PascalPflueger/Schwarmroboter-Beachlorarbeit-/Bilder/Screenshot_3.png

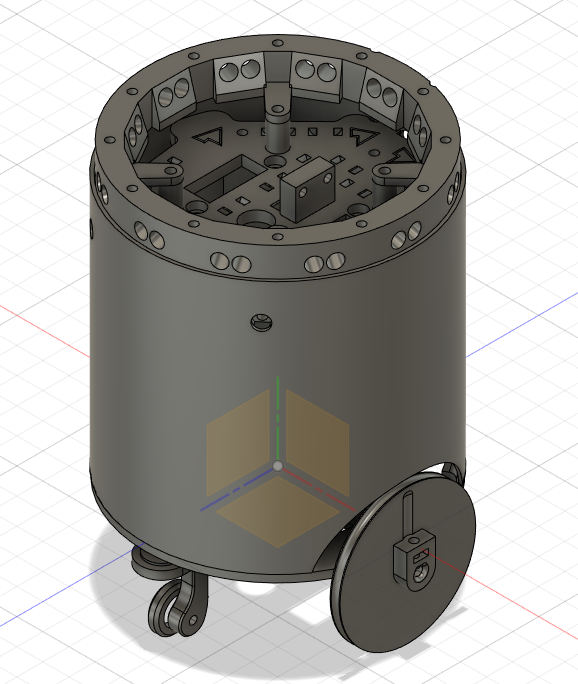
Bilder/Screenshot_3.png
