PascalPflueger/Schwarmroboter-Beachlorarbeit-/Bilder/IMG_5607.JPG

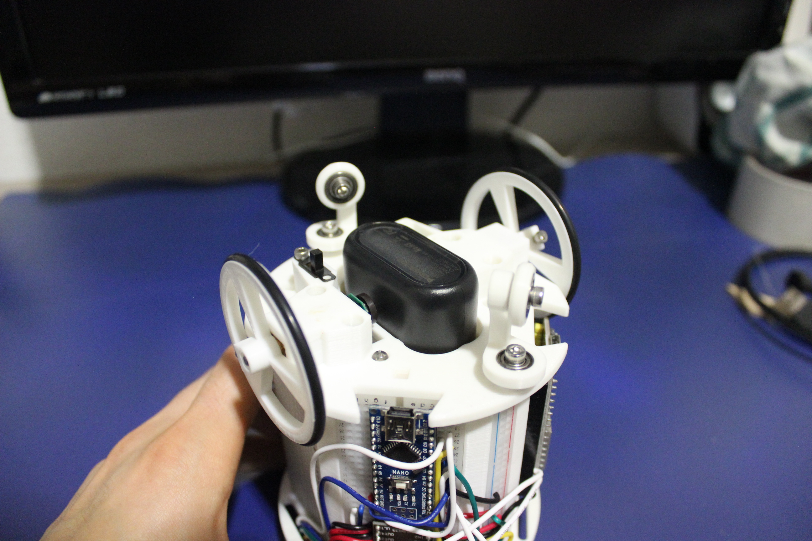
Bilder/IMG_5607.JPG
