PascalPflueger/Schwarmroboter-Beachlorarbeit-/3D-gedruckte Bauteile/Hauptkörper 1.png

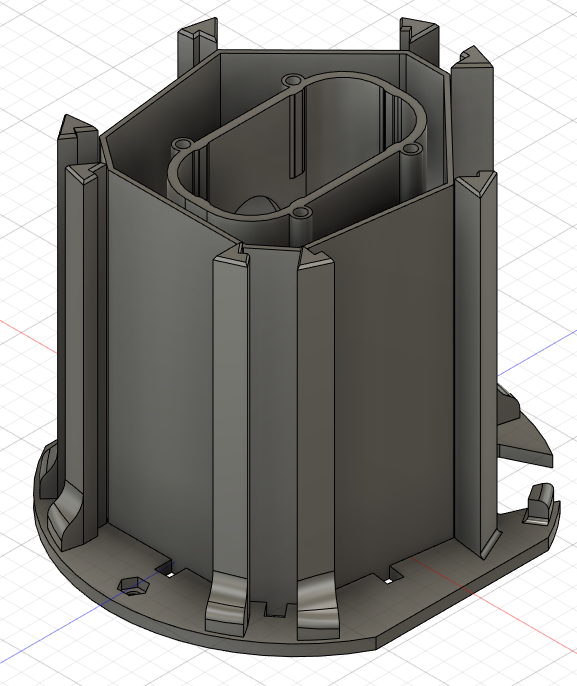
3D-gedruckte Bauteile/Hauptkörper 1.png
