PascalPflueger/Schwarmroboter-Beachlorarbeit-/3D-gedruckte Bauteile/Hauptkörper 2.png

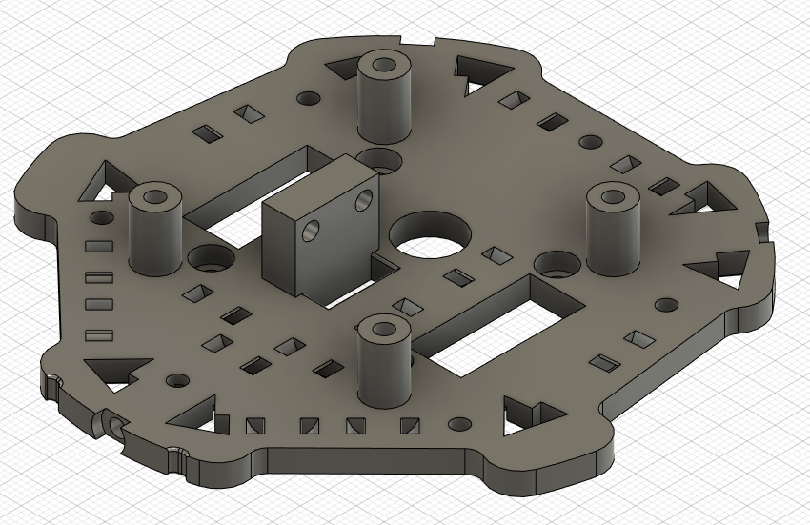
3D-gedruckte Bauteile/Hauptkörper 2.png
