PascalPflueger/Schwarmroboter-Beachlorarbeit-/3D-gedruckte Bauteile/Hülle.png

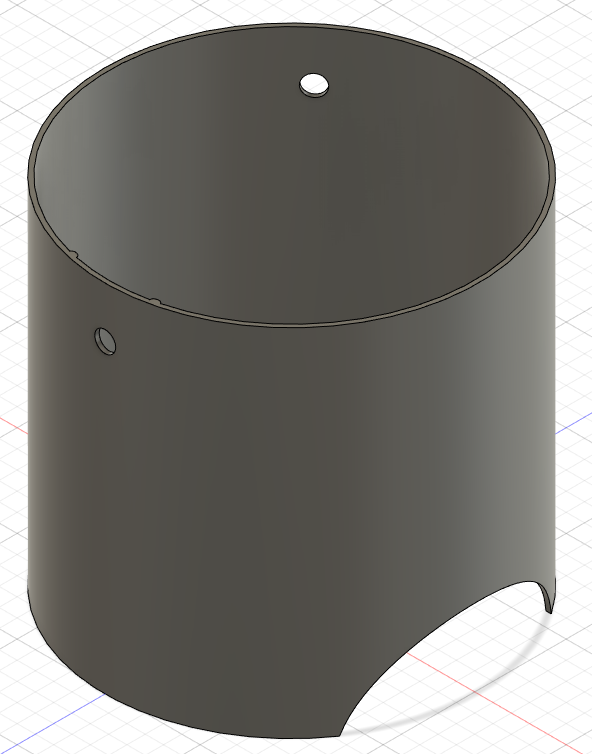
3D-gedruckte Bauteile/Hülle.png
