PascalPflueger/Schwarmroboter-Beachlorarbeit-/3D-gedruckte Bauteile/IR-Sensor-Halterung.png

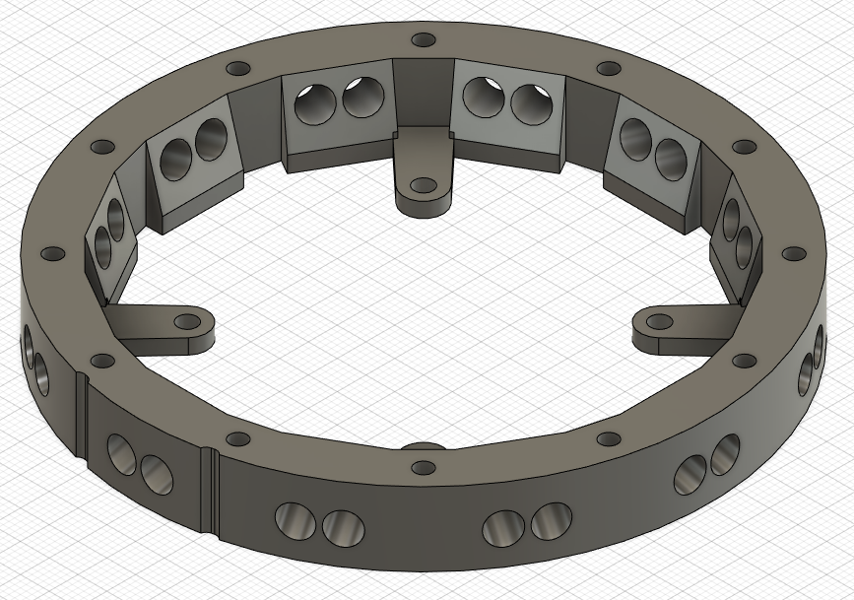
3D-gedruckte Bauteile/IR-Sensor-Halterung.png
