PascalPflueger/Schwarmroboter-Beachlorarbeit-/3D-gedruckte Bauteile/Motorhalterung Links.png

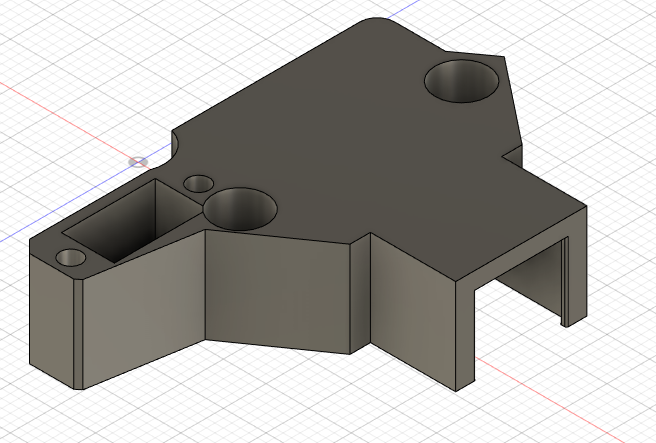
3D-gedruckte Bauteile/Motorhalterung Links.png
