PascalPflueger/Schwarmroboter-Beachlorarbeit-/3D-gedruckte Bauteile/Motorhalterung Rechts.png

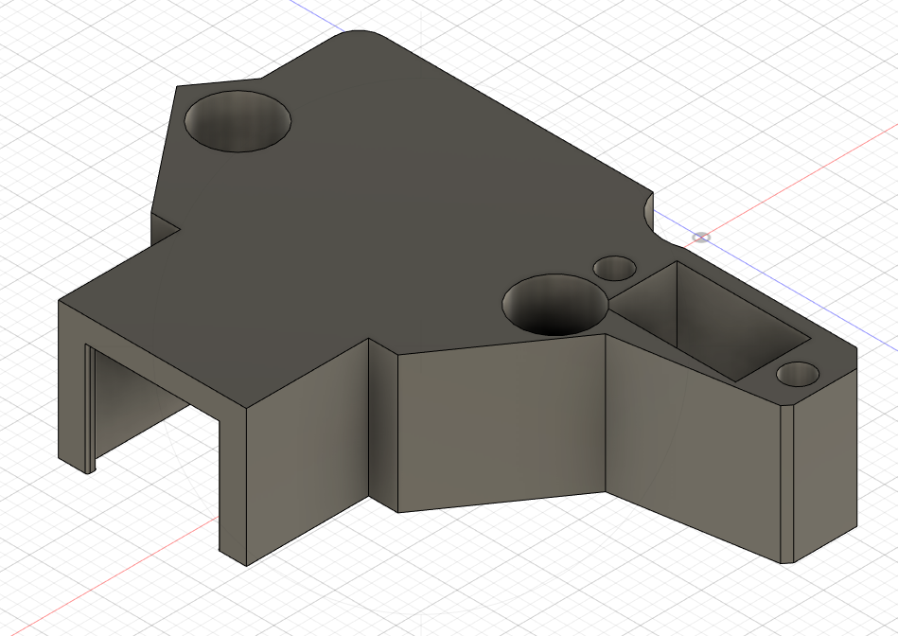
3D-gedruckte Bauteile/Motorhalterung Rechts.png
