PascalPflueger/Schwarmroboter-Beachlorarbeit-/3D-gedruckte Bauteile/Rad.png

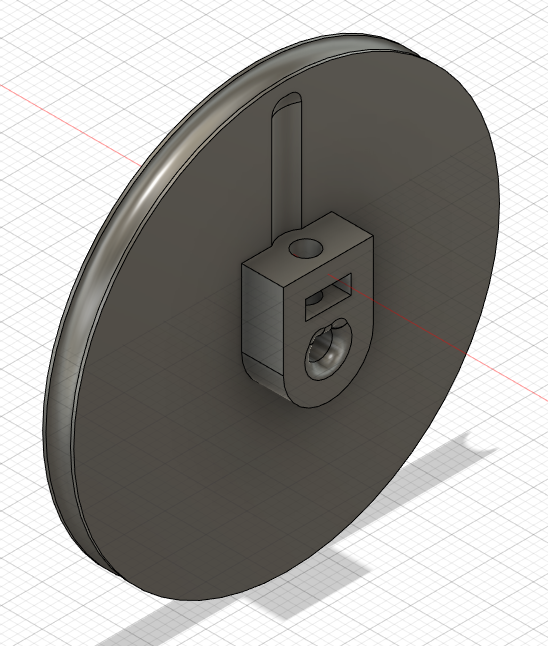
3D-gedruckte Bauteile/Rad.png
