PascalPflueger/Schwarmroboter-Beachlorarbeit-/3D-gedruckte Bauteile/Spannungsregel-Halterung.png

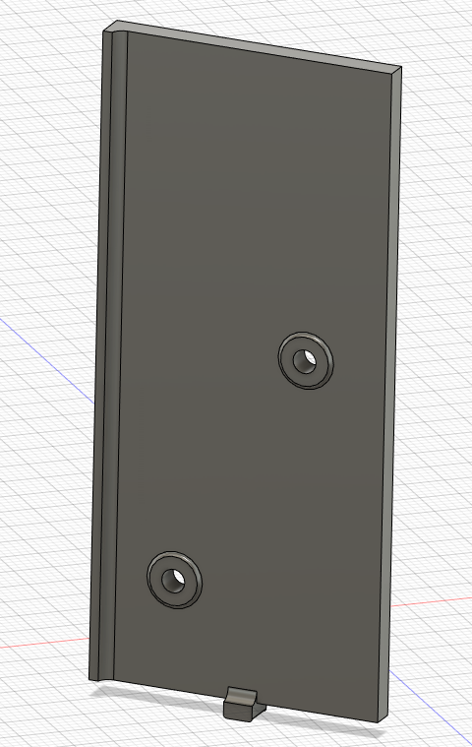
3D-gedruckte Bauteile/Spannungsregel-Halterung.png
