PascalPflueger/Schwarmroboter-Beachlorarbeit-/3D-gedruckte Bauteile/Stützrad Teil 1-3.png

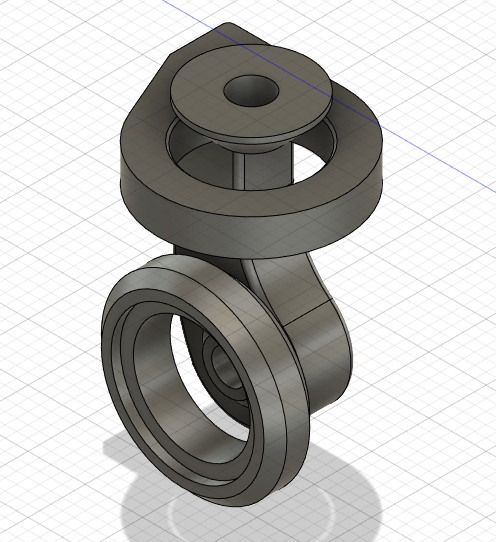
3D-gedruckte Bauteile/Stützrad Teil 1-3.png
