PascalPflueger/Schwarmroboter-Beachlorarbeit-/Bilder/ESP Code Diagram.png

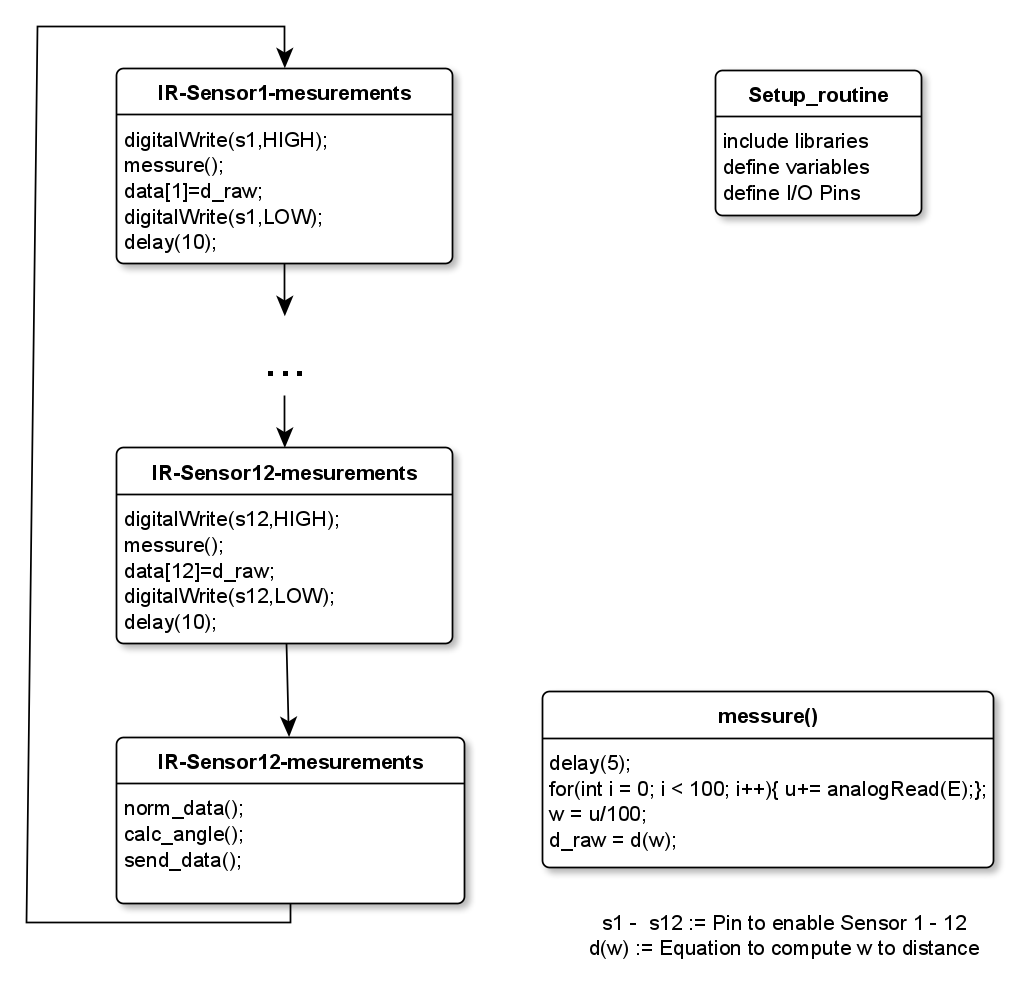
Bilder/ESP Code Diagram.png
