PascalPflueger/Schwarmroboter-Beachlorarbeit-/Bilder/IMG_5568.JPG

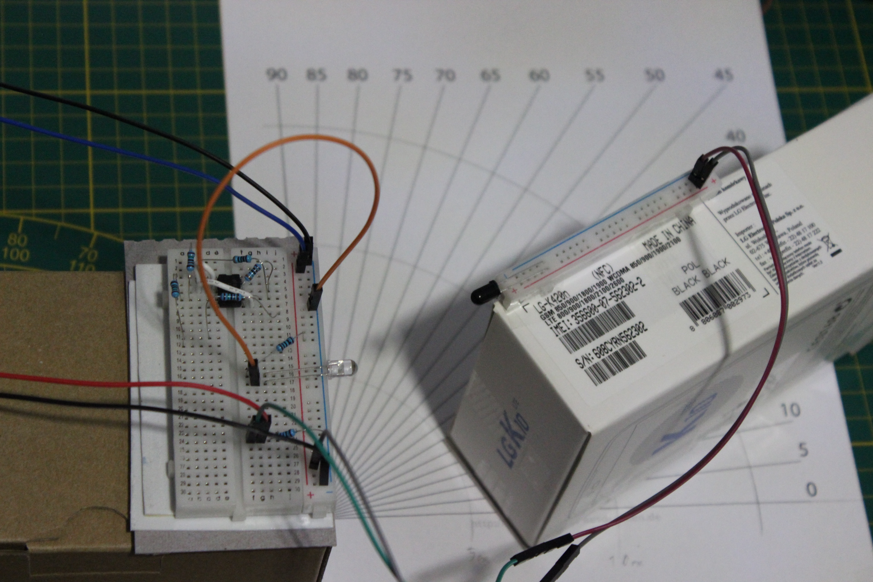
Bilder/IMG_5568.JPG
