PascalPflueger/Schwarmroboter-Beachlorarbeit-/Bilder/IMG_5569.JPG

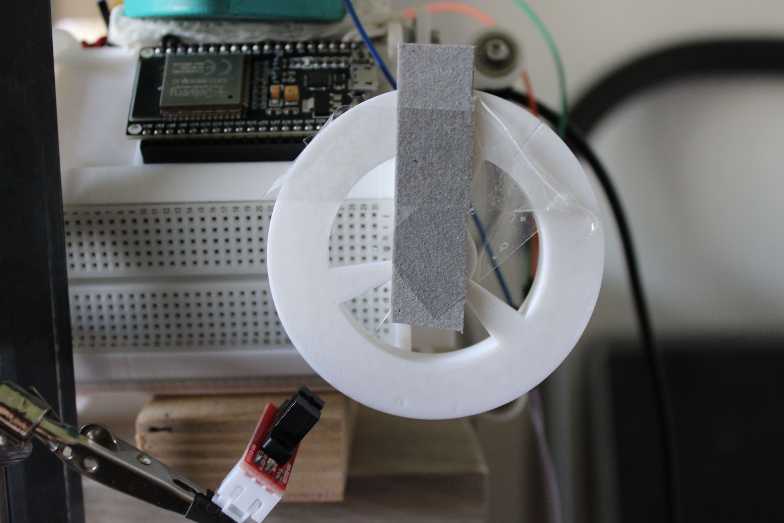
Bilder/IMG_5569.JPG
