PascalPflueger/Schwarmroboter-Beachlorarbeit-/Bilder/IMG_5602.JPG

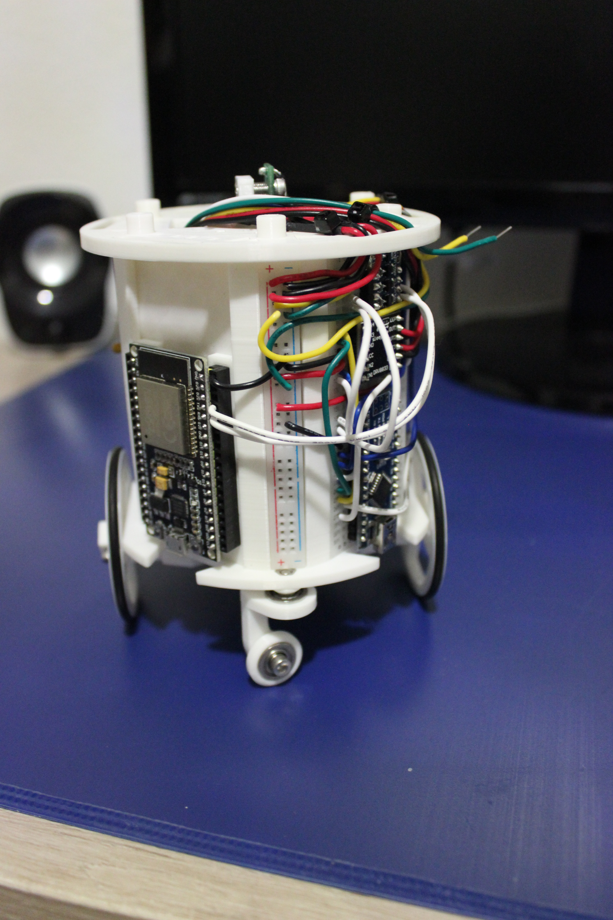
Bilder/IMG_5602.JPG
