PascalPflueger/Schwarmroboter-Beachlorarbeit-/Bilder/IMG_5603.JPG

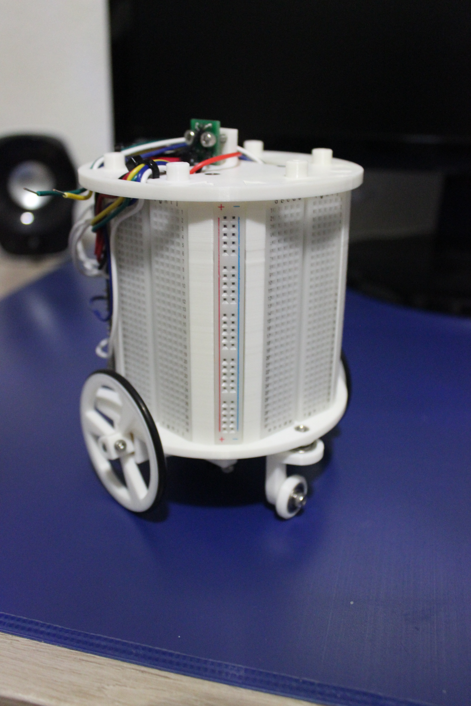
Bilder/IMG_5603.JPG
