PascalPflueger/Schwarmroboter-Beachlorarbeit-/Bilder/IMG_5604.JPG

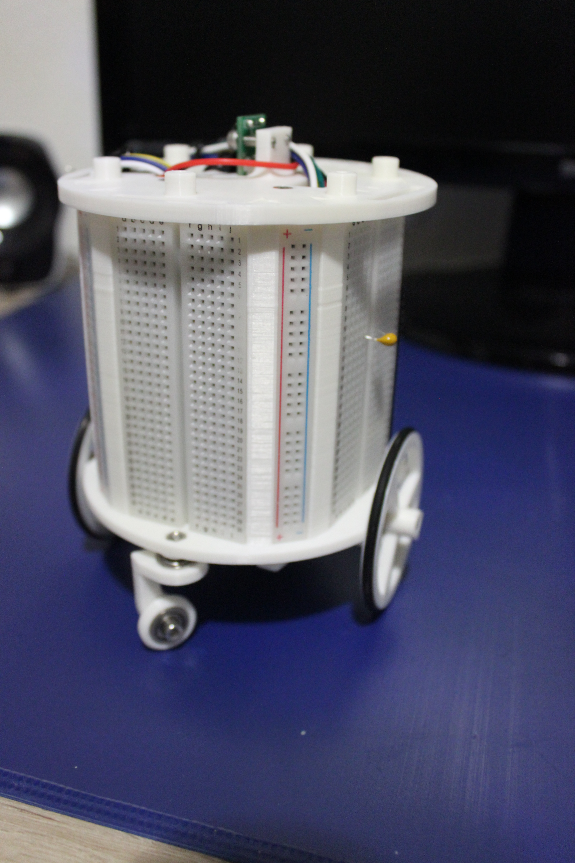
Bilder/IMG_5604.JPG
