PascalPflueger/Schwarmroboter-Beachlorarbeit-/Bilder/IMG_5606.JPG

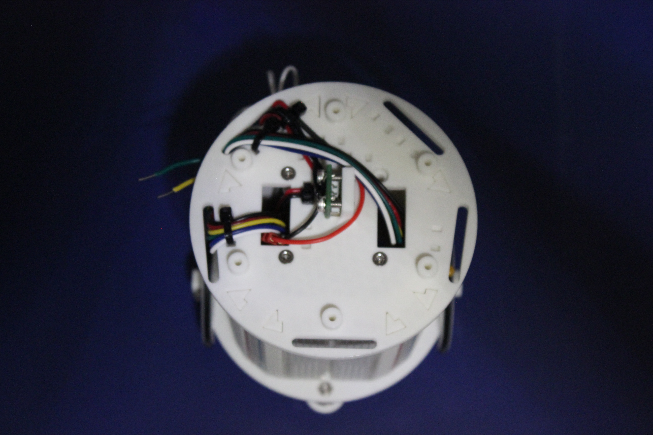
Bilder/IMG_5606.JPG
