PascalPflueger/Schwarmroboter-Beachlorarbeit-/Bilder/IMG_5608.JPG

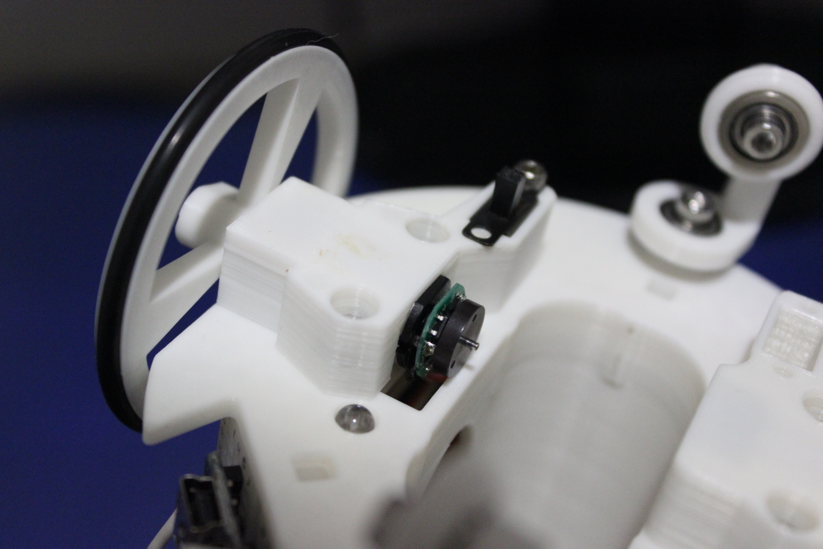
Bilder/IMG_5608.JPG
