PascalPflueger/Schwarmroboter-Beachlorarbeit-/Bilder/IMG_5610.JPG

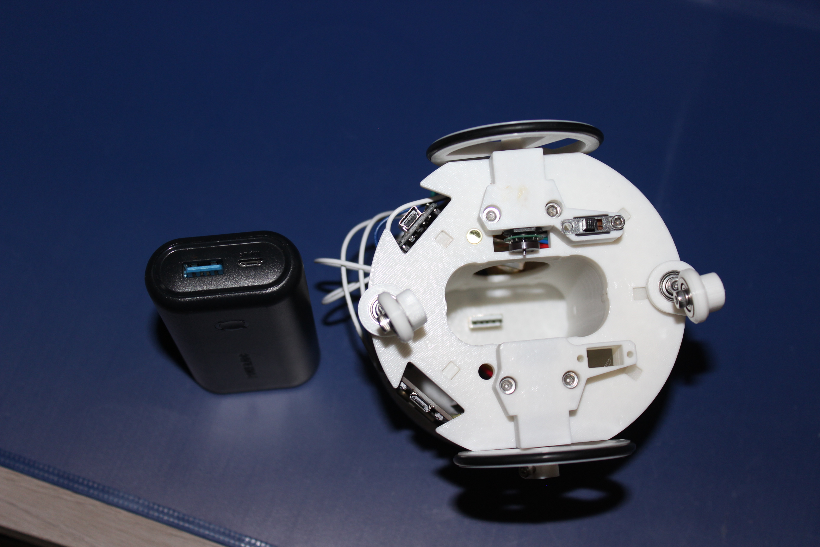
Bilder/IMG_5610.JPG
