PascalPflueger/Schwarmroboter-Beachlorarbeit-/Bilder/IMG_5614.JPG

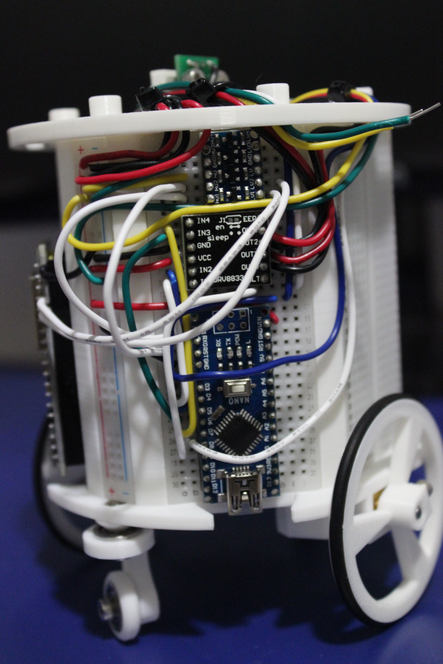
Bilder/IMG_5614.JPG
