PascalPflueger/Schwarmroboter-Beachlorarbeit-/Bilder/IMG_5636.JPG

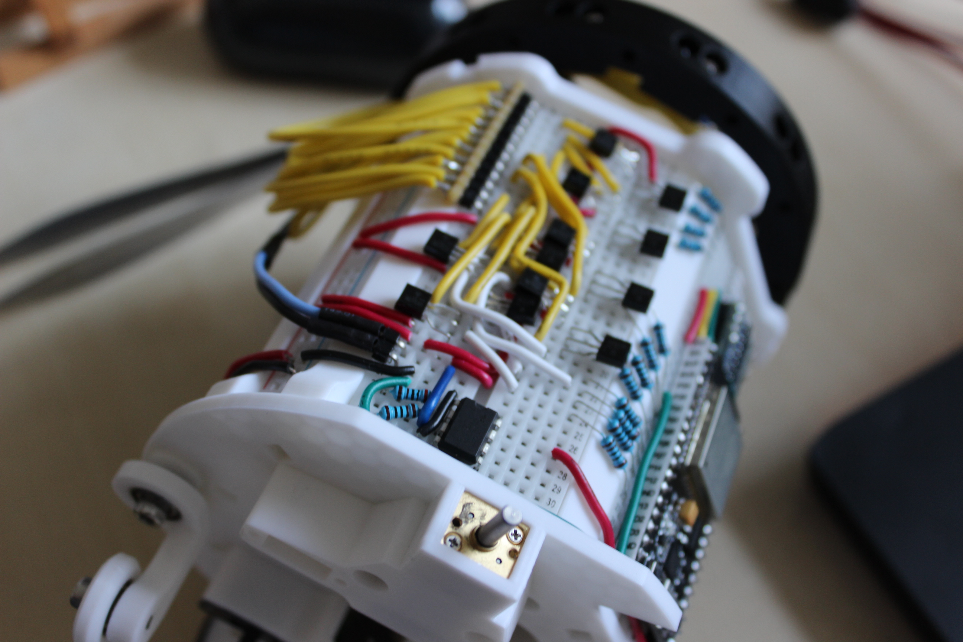
Bilder/IMG_5636.JPG
