PascalPflueger/Schwarmroboter-Beachlorarbeit-/Bilder/IMG_5637.JPG

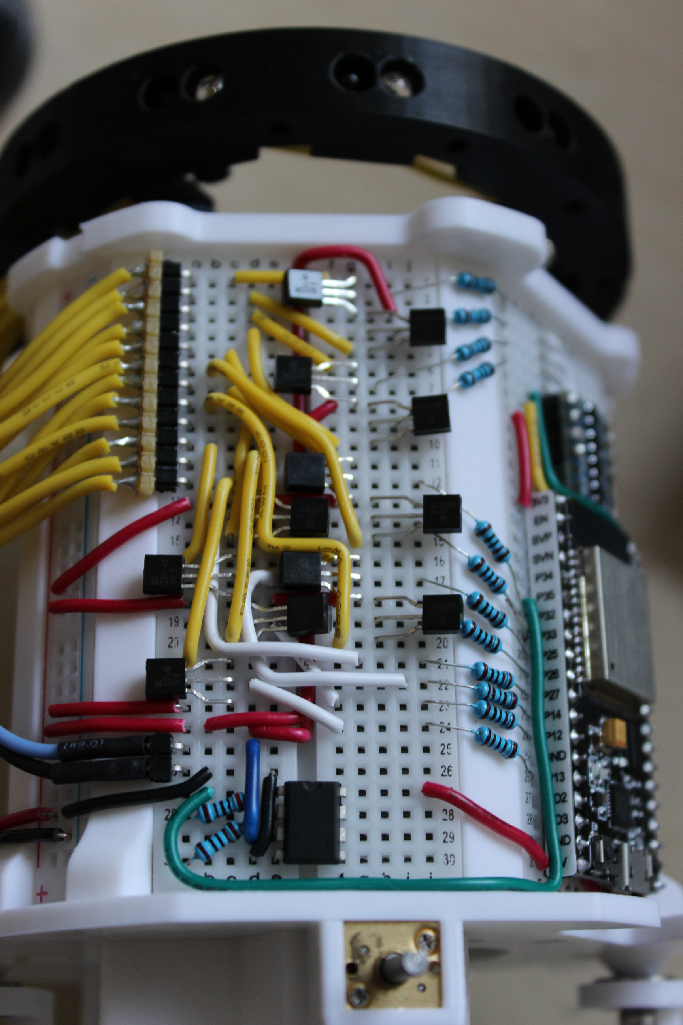
Bilder/IMG_5637.JPG
