PascalPflueger/Schwarmroboter-Beachlorarbeit-/Bilder/IMG_5638.JPG

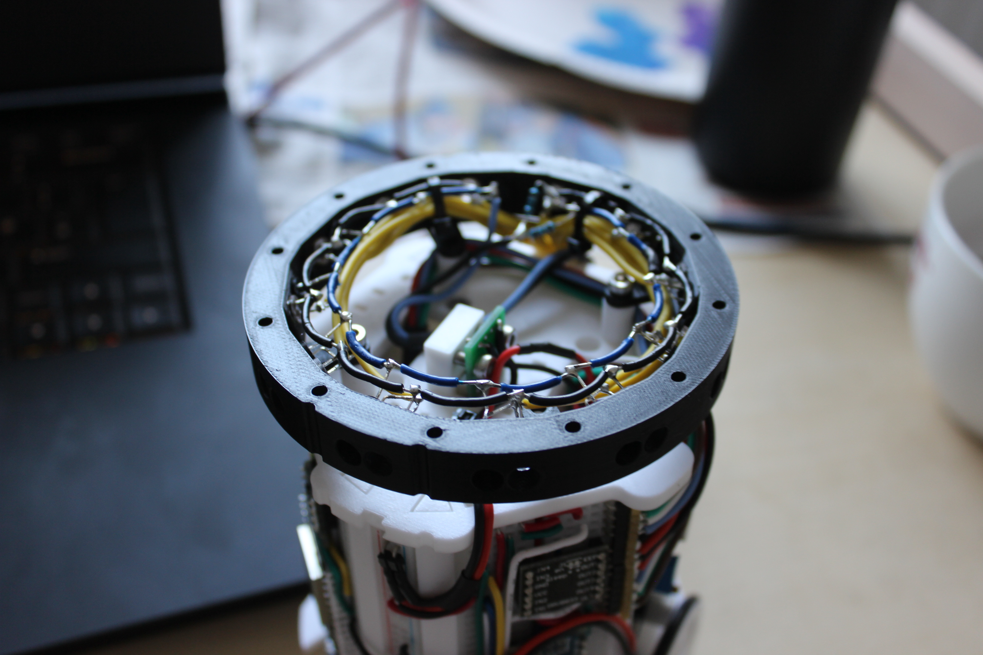
Bilder/IMG_5638.JPG
