PascalPflueger/Schwarmroboter-Beachlorarbeit-/Bilder/IMG_5639.JPG

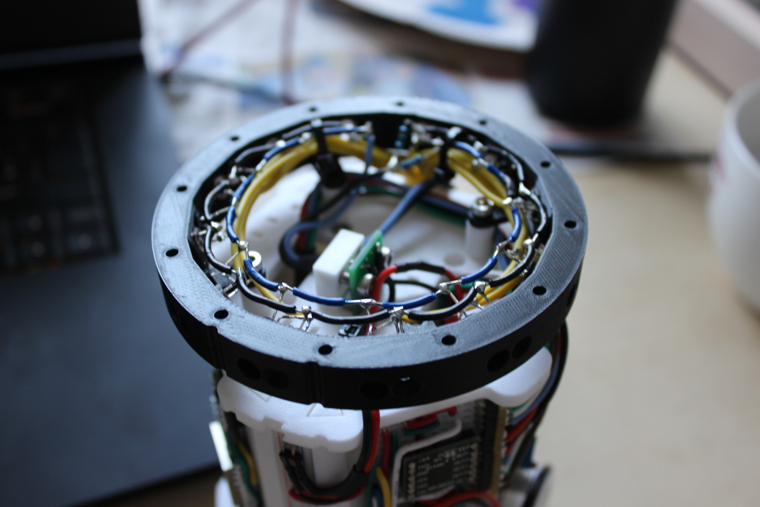
Bilder/IMG_5639.JPG
