PascalPflueger/Schwarmroboter-Beachlorarbeit-/Bilder/IMG_20220608_231935_DRO.jpg

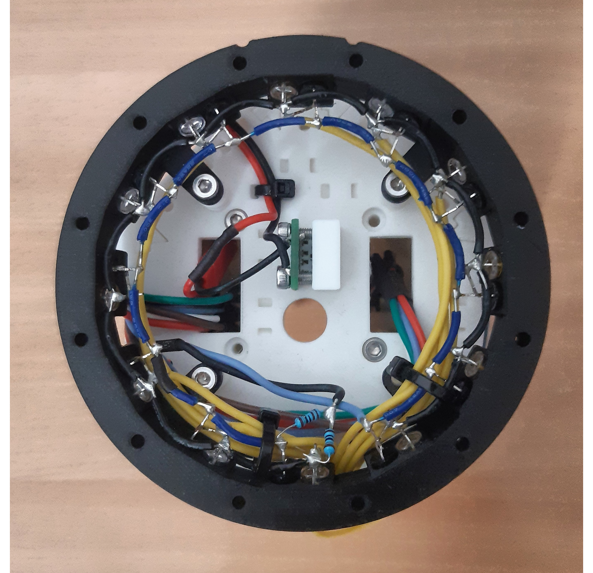
Bilder/IMG_20220608_231935_DRO.jpg
