PascalPflueger/Schwarmroboter-Beachlorarbeit-/Bilder/IMG_20220608_234012_DRO.jpg

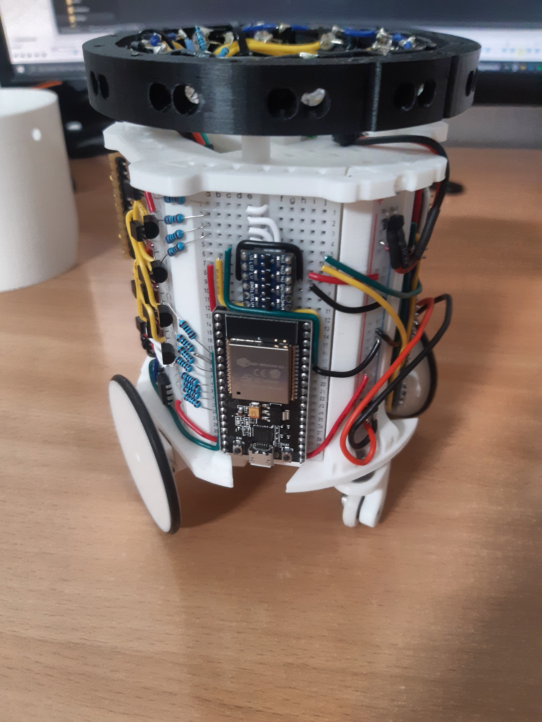
Bilder/IMG_20220608_234012_DRO.jpg
