PascalPflueger/Schwarmroboter-Beachlorarbeit-/Bilder/IMG_20220608_234020_DRO.jpg

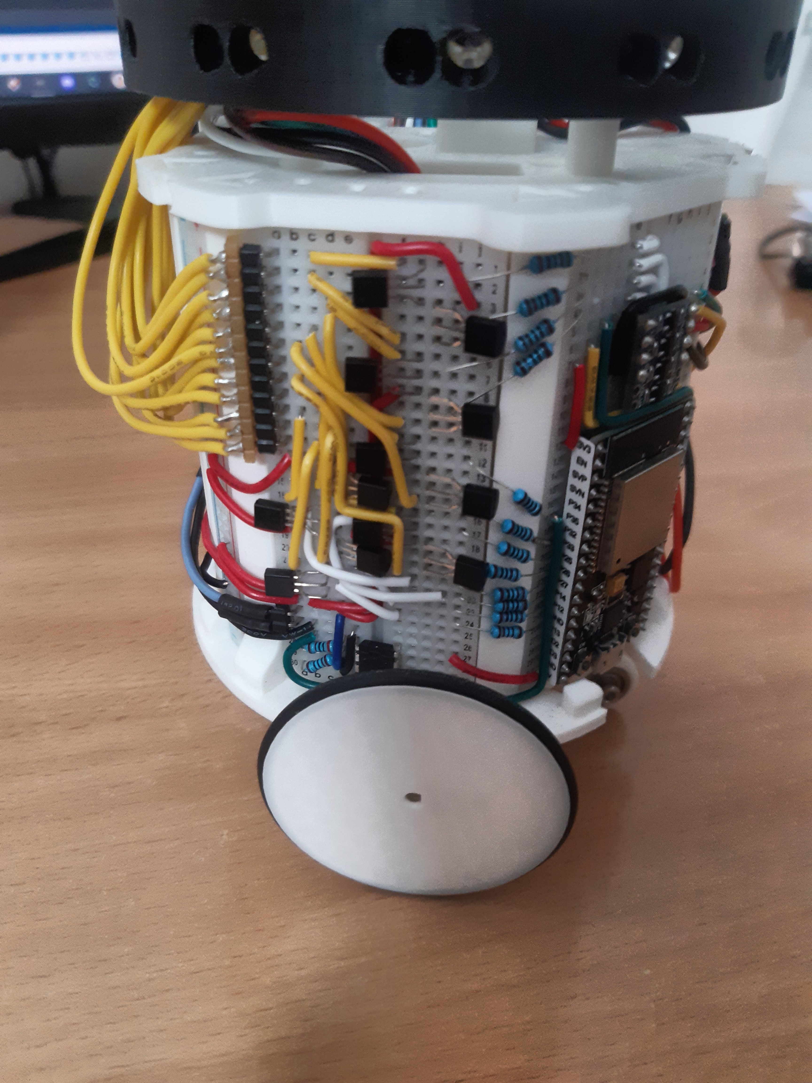
Bilder/IMG_20220608_234020_DRO.jpg
