PascalPflueger/Schwarmroboter-Beachlorarbeit-/Bilder/IMG_20220608_234028_DRO.jpg

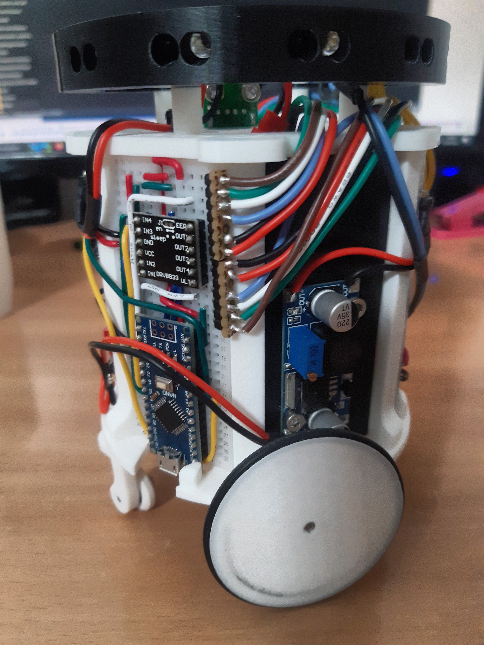
Bilder/IMG_20220608_234028_DRO.jpg
