PascalPflueger/Schwarmroboter-Beachlorarbeit-/Bilder/IR-Sensorring.jpg

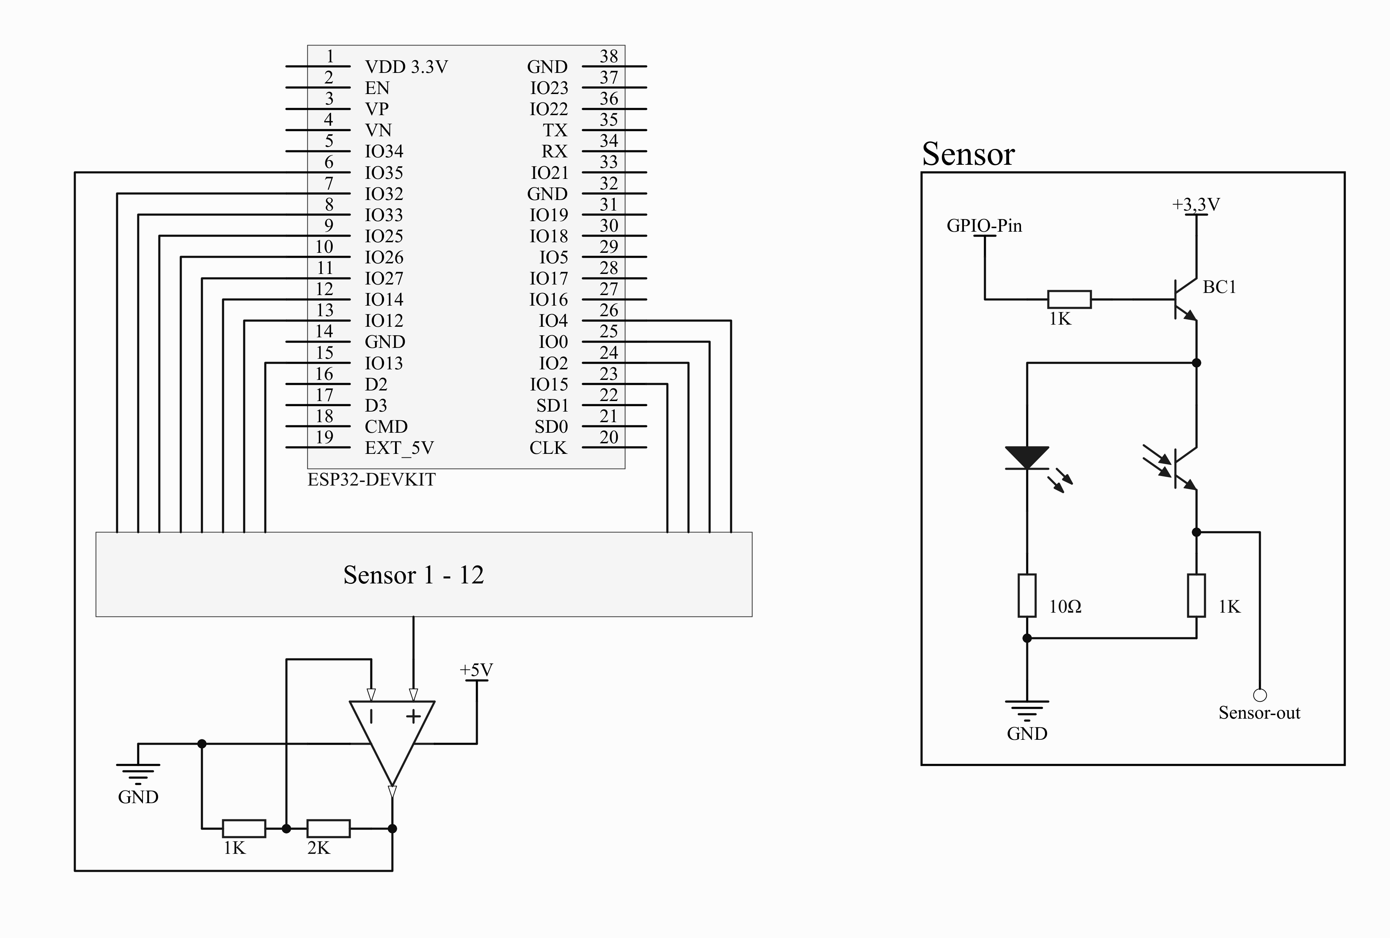
Bilder/IR-Sensorring.jpg
