PascalPflueger/Schwarmroboter-Beachlorarbeit-/Bilder/Motorsteuerung Diagram.png

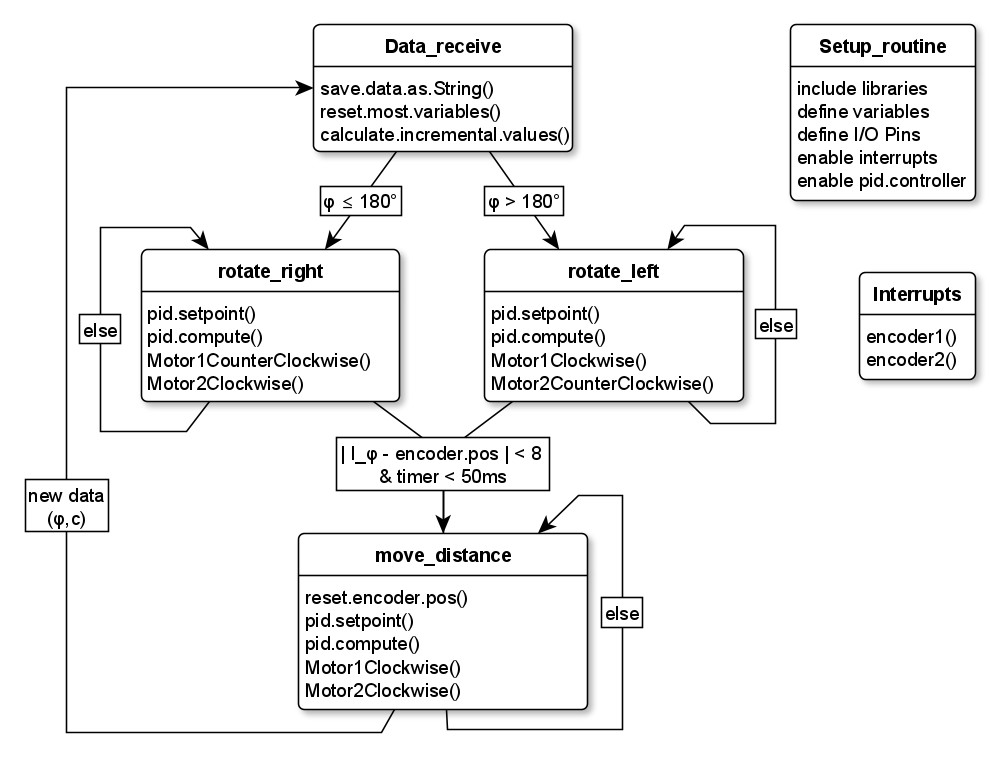
Bilder/Motorsteuerung Diagram.png
