PascalPflueger/Schwarmroboter-Beachlorarbeit-/Bilder/Screenshot_1.png

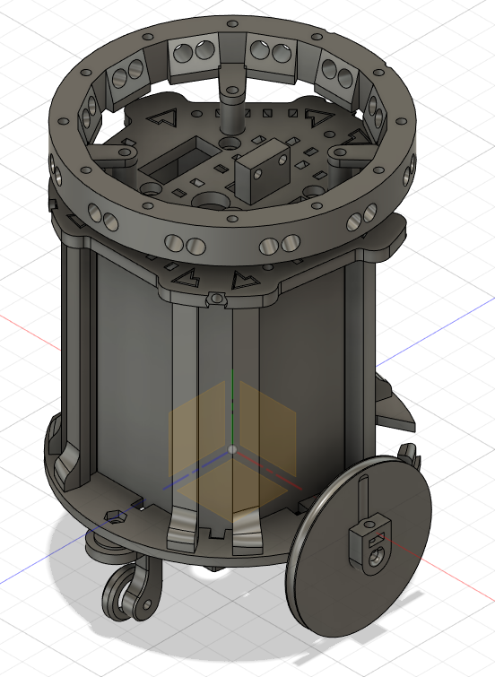
Bilder/Screenshot_1.png
