PascalPflueger/Schwarmroboter-Beachlorarbeit-/Bilder/Screenshot_27.png

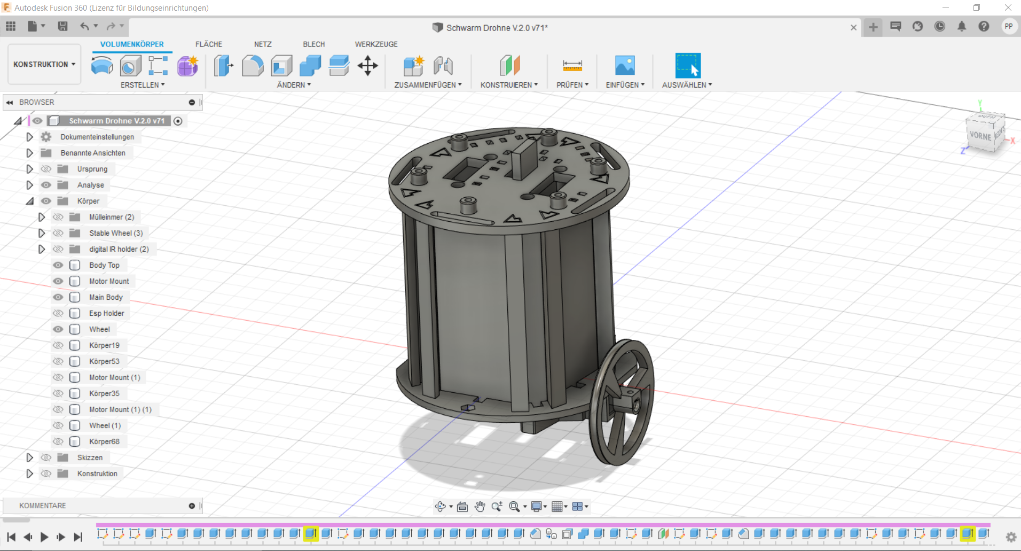
Bilder/Screenshot_27.png
