PascalPflueger/Schwarmroboter-Beachlorarbeit-/Bauteilliste mit Kosten und Links.xlsx

Bauteile | Menge pro Roboter | Anzahl pro Angebot | Preis pro Angebot | Preis pro Roboter | Link
Steckbretter | 5 | 5 | 7.99 € | 7.99 € | https://www.amazon.de/dp/B07VFK5CRP/ref=twister_B07Z6FRCJN?_encoding=UTF8&psc=1
Powerbank | 1 | 1 | 15.99 € | 15.99 € | https://www.amazon.de/EnergyCell-Powerbank-Kompakter-Tragbares-Smartphones-Schwarz/dp/B099S2SPTB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
USB 2.0 Buchse | 1 | 10 | 3.99 € | 0.40 € | https://www.amazon.de/dp/B07TTH6JYV/?coliid=I2RC22K7BX7TAX&colid=117FDAQ60NUMF
Esp32 | 1 | 1 | 10.99 € | 10.99 € | https://www.amazon.de/dp/B07PG923ZK/?coliid=IS52WNDU5OQP4&colid=117FDAQ60NUMF
Arduino Nano Clone (micro USB) | 1 | 1 | 8.00 € | 8.00 € | https://de.aliexpress.com/item/1005001621774865.html
6V DC Getriebemotor mit Encoder | 2 | 1 | 16.89 € | 33.78 € | https://www.amazon.de/Getriebemotor-GBMQ-GM12BY20-magnetischem-codiertem-Disketten-Hall-Kodierer/dp/B07HN8SQWN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
IR-Diode und Empfänger | 12 | 50 | 16.19 € | 3.89 € | https://www.amazon.de/BESTOMZ-Leuchtdioden-Infrarot-Diode-Emission-Empf%C3%A4nger-Schwarz/dp/B077ZDSYVR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
DRV8833 2 Kanal H-Brücke | 1 | 3 | 8.99 € | 3.00 € | https://www.amazon.de/Haljia-DRV8833-Kanal-Getriebemotor-Treiberplatine/dp/B071SJ4T9M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
LM238 Operationsverstärker | 1 | 50 | 8.99 € | 0.18 € | https://www.amazon.de/BOJACK-Pr%C3%A4zisions-Dual-Operationsverst%C3%A4rker-Kunststoffpaket-Patch-Typ-%EF%BC%88Packung/dp/B08F31QC5S
BC337-Transistor | 12 | 50 | 2.80 € | 0.67 € | https://www.amazon.de/BC337-Transistor-TO92-Transistoren-BC337-40/dp/B01H27NB8Q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
Abwärtswandler | 1 | 5 | 10.59 € | 2.12 € | https://www.amazon.de/Yizhet-Stromversorgung-Abw%C3%A4rtswandler-Einstellbares-Abw%C3%A4rtsmodul/dp/B0823P6PW6
4-Kanal Pegelwandler | 1 | 15 | 7.99 € | 0.53 € | https://www.amazon.de/RUNCCI-YUN-Pegelwandler-Converter-BiDirektional-Mikrocontroller/dp/B082F6BSB5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
Wiederstände | - | - | - | 0.10 € | -
Schiebeschalter | 1 | 90 | 9.19 € | 0.10 € | https://www.amazon.de/TXErfolg-Schiebeschalter-Kippschalter-Wechselschalter-Mini-Format/dp/B087R8JHL5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
90-Grad Stiftleisten | 1 | 20 | 15.50 € | 0.78 € | https://www.amazon.de/Aexit-Doppelreihe-St%C3%BCck-Grad-Verbindungswinkel/dp/B07BDLC1PM
22awg Draht (solide und flexibel) | - | - | - | 4.00 € | https://www.amazon.de/Elektrischer-anschlie%C3%9Fen-Litzendraht-Kupferdraht-Temperaturbest%C3%A4ndigkeit/dp/B08BZKM7R5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
50mm*3mm O Ring | 2 | 10 | 5.49 € | 1.10 € | https://www.amazon.de/sourcing-map-Dichtring-Dichtung-Schwarz/dp/B00VG9QYEK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
F623ZZ Flansch-Kugellager (3x10x4)mm | 4 | 10 | 7.95 € | 3.18 € | https://www.amazon.de/RoboMall-10x-Miniatur-Kugellager-F623ZZ-4mm/dp/B01GO3P1QY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
Zylinderkopfschraube M3x10mm | 20 | - | - | 4.00 € | -
Zylinderkopfschraube M3x5mm | 3 | - | - | - | -
Sechskantmutter M3 | 2 | - | - | - | -
Zylinderkopfschraube M2,5x4mm | 1 | - | - | - | -
Gesammtpreis pro Roboter |  |  |  | 100.79 €
