PascalPflueger/Schwarmroboter-Beachlorarbeit-/3D-gedruckte Bauteile/Hülle.stl

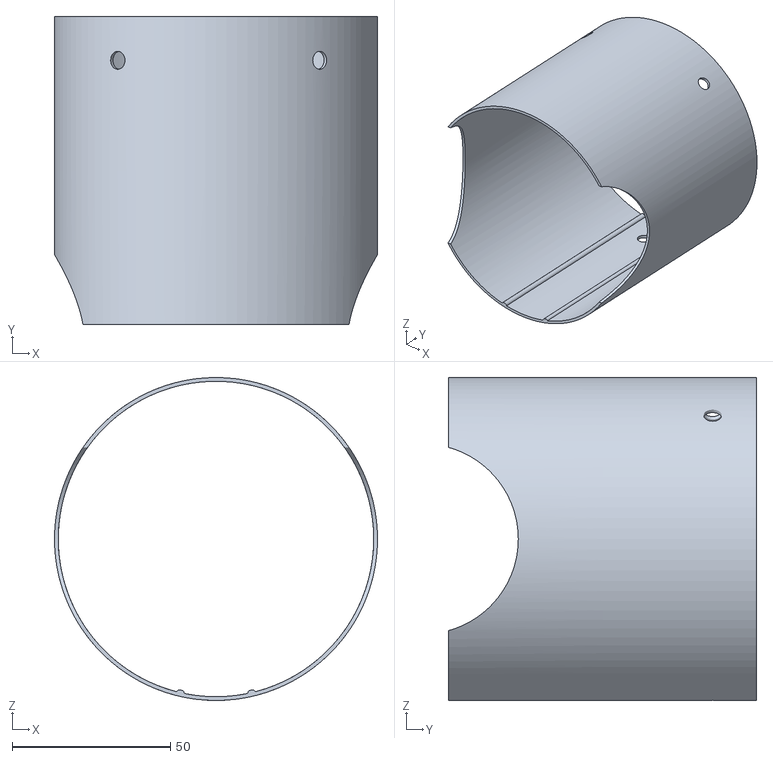
[picture p34: CAD file, 2022-07-24]
3D-gedruckte Bauteile/Hülle.stl
102.0 x 97.2 x 102.0
