PascalPflueger/Schwarmroboter-Beachlorarbeit-/3D-gedruckte Bauteile/Spannungsregel-Halterung.stl

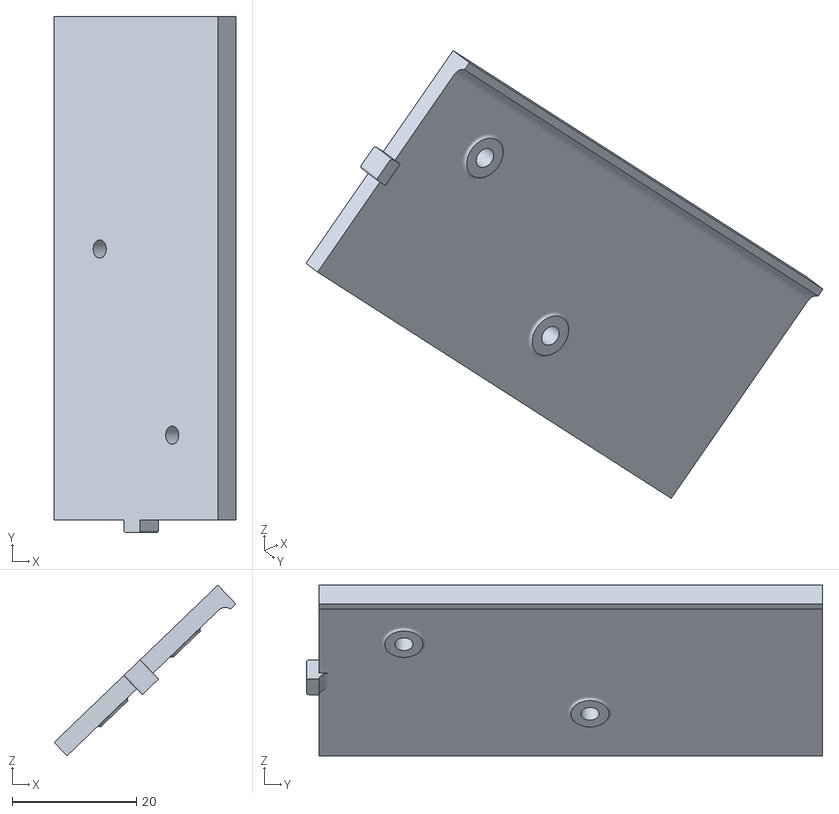
[picture p35: CAD file, 2022-07-24]
3D-gedruckte Bauteile/Spannungsregel-Halterung.stl
29.3 x 83.2 x 27.5
