PascalPflueger/Schwarmroboter-Beachlorarbeit-/3D-gedruckte Bauteile/Rad.stl

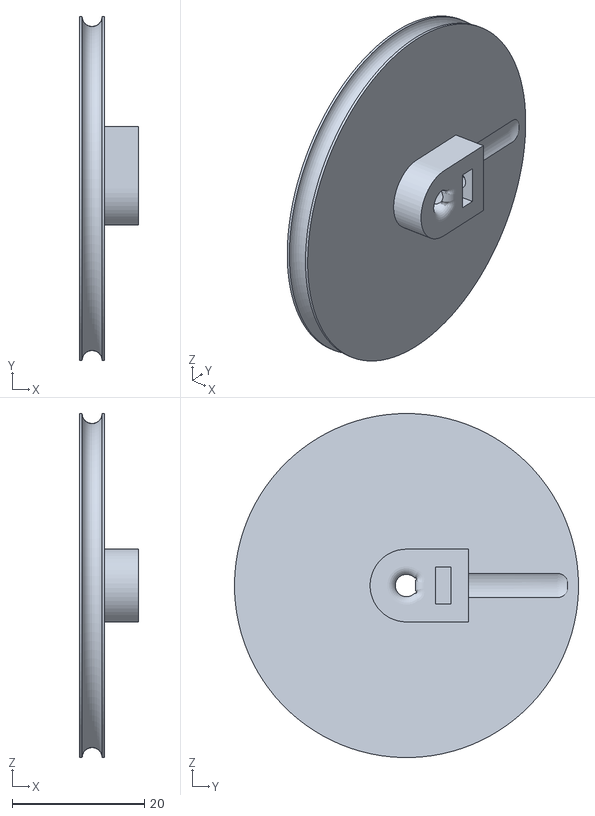
[picture p36: CAD file, 2022-07-24]
3D-gedruckte Bauteile/Rad.stl
8.90 x 52.0 x 52.0
