PascalPflueger/Schwarmroboter-Beachlorarbeit-/3D-gedruckte Bauteile/Hauptkörper 1.stl

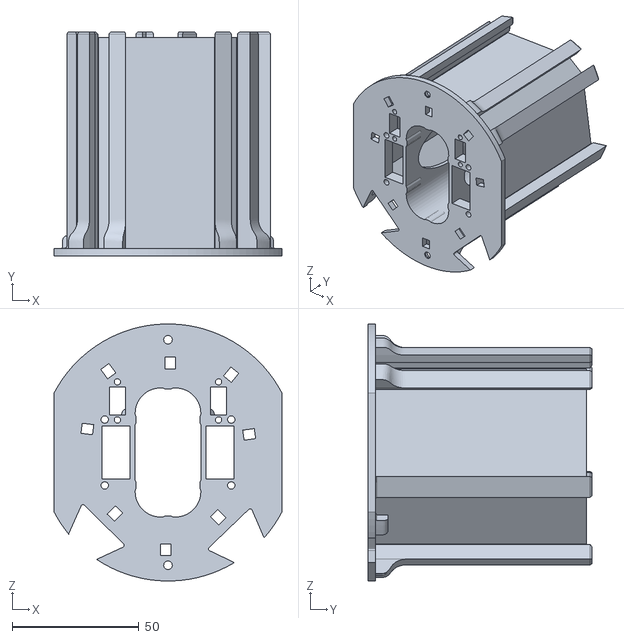
[picture p37: CAD file, 2022-07-24]
3D-gedruckte Bauteile/Hauptkörper 1.stl
89.9 x 88.4 x 101.4
