PascalPflueger/Schwarmroboter-Beachlorarbeit-/3D-gedruckte Bauteile/Stützrad Teil 1.stl

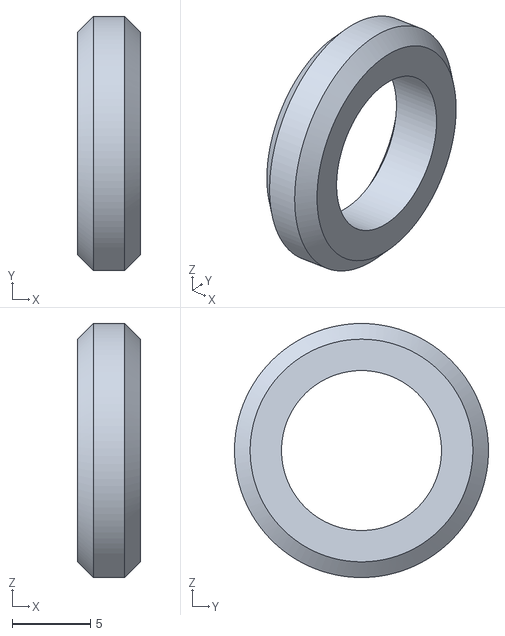
[picture p38: CAD file, 2022-07-24]
3D-gedruckte Bauteile/Stützrad Teil 1.stl
4.00 x 16.2 x 16.2
