PascalPflueger/Schwarmroboter-Beachlorarbeit-/3D-gedruckte Bauteile/Motorhalterung Links.stl

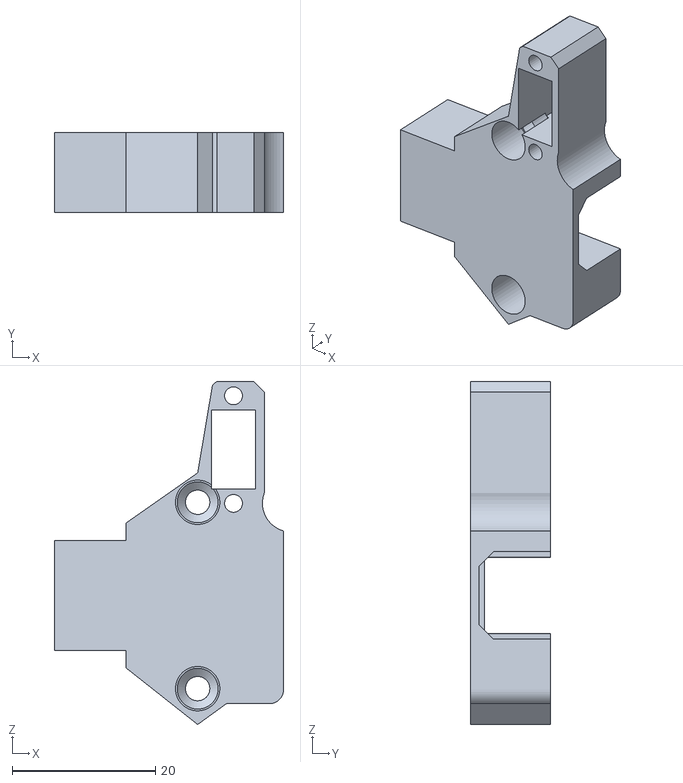
[picture p39: CAD file, 2022-07-24]
3D-gedruckte Bauteile/Motorhalterung Links.stl
32.0 x 11.2 x 47.8
