PascalPflueger/Schwarmroboter-Beachlorarbeit-/3D-gedruckte Bauteile/Hauptkörper 2.stl

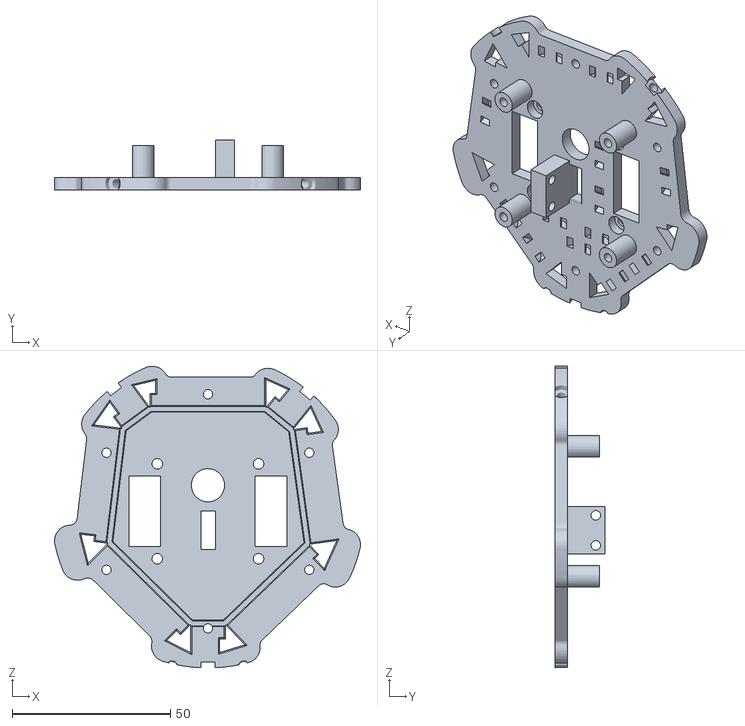
[picture p40: CAD file, 2022-07-24]
3D-gedruckte Bauteile/Hauptkörper 2.stl
96.7 x 15.8 x 95.3
