PascalPflueger/Schwarmroboter-Beachlorarbeit-/3D-gedruckte Bauteile/IR-Sensor-Halterung.stl

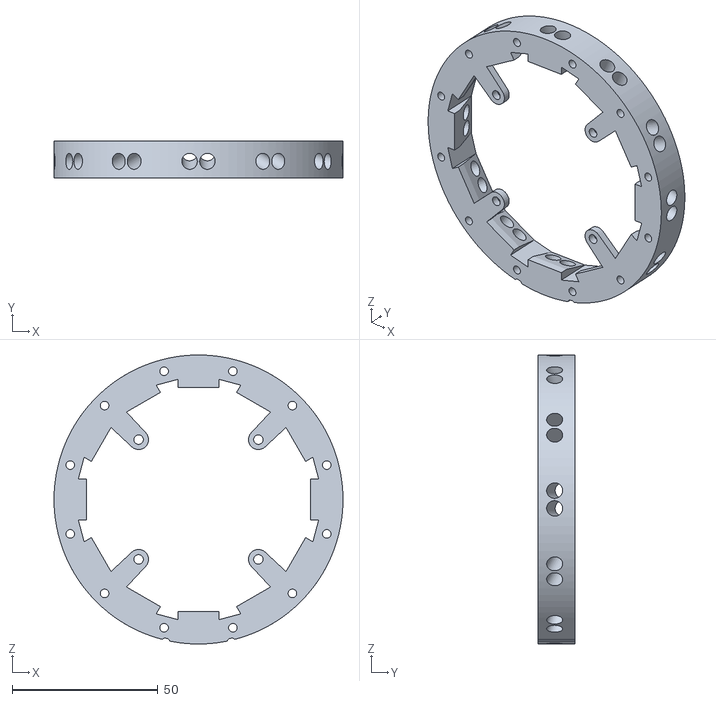
[picture p41: CAD file, 2022-07-24]
3D-gedruckte Bauteile/IR-Sensor-Halterung.stl
99.0 x 12.8 x 99.0
