PascalPflueger/Schwarmroboter-Beachlorarbeit-/3D-gedruckte Bauteile/Stützrad Teil 2.stl

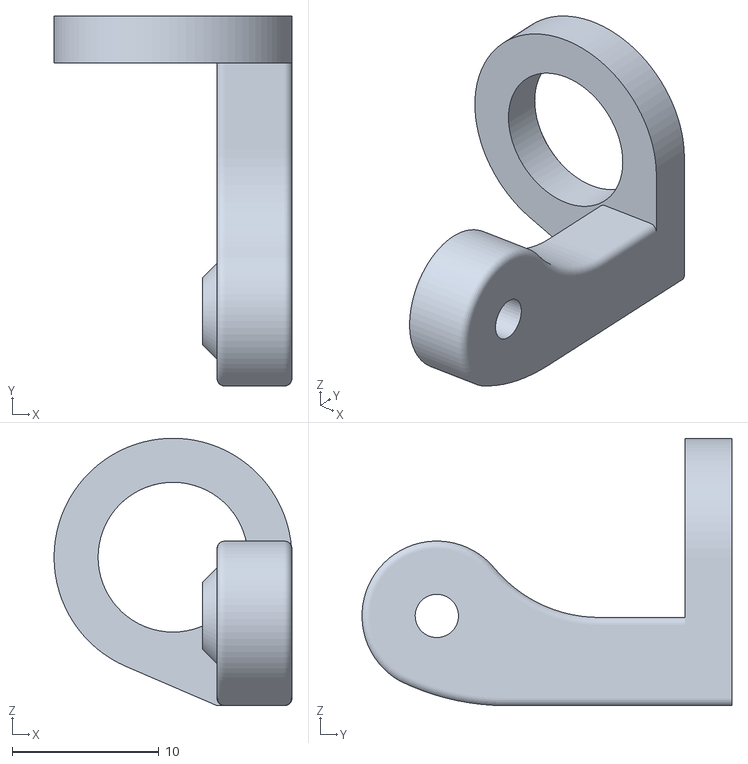
[picture p42: CAD file, 2022-07-24]
3D-gedruckte Bauteile/Stützrad Teil 2.stl
16.2 x 25.2 x 18.2
