PascalPflueger/Schwarmroboter-Beachlorarbeit-/3D-gedruckte Bauteile/Stützrad Teil 3.stl

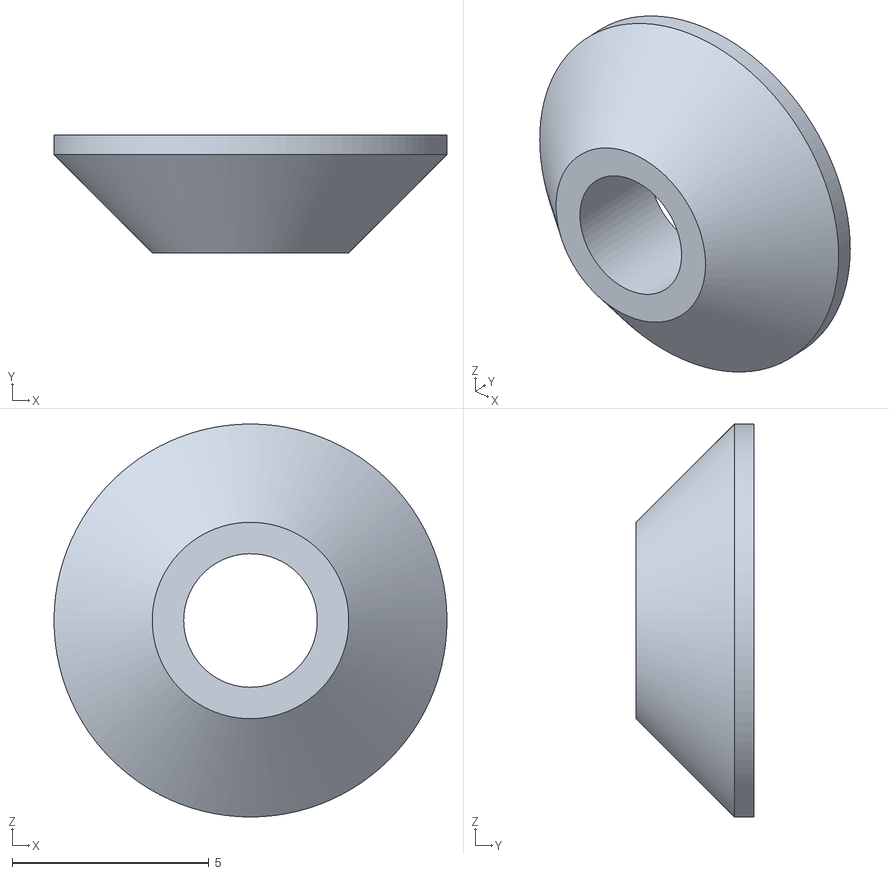
[picture p43: CAD file, 2022-07-24]
3D-gedruckte Bauteile/Stützrad Teil 3.stl
10.0 x 3.00 x 10.0
