PascalPflueger/Schwarmroboter-Beachlorarbeit-/(list of files, cad)

Other CAD files:
3D-gedruckte Bauteile/Motorhalterung Rechts.stl
